acosborn/flow_sensor/projects/flow_sensor/board2/board_all.png

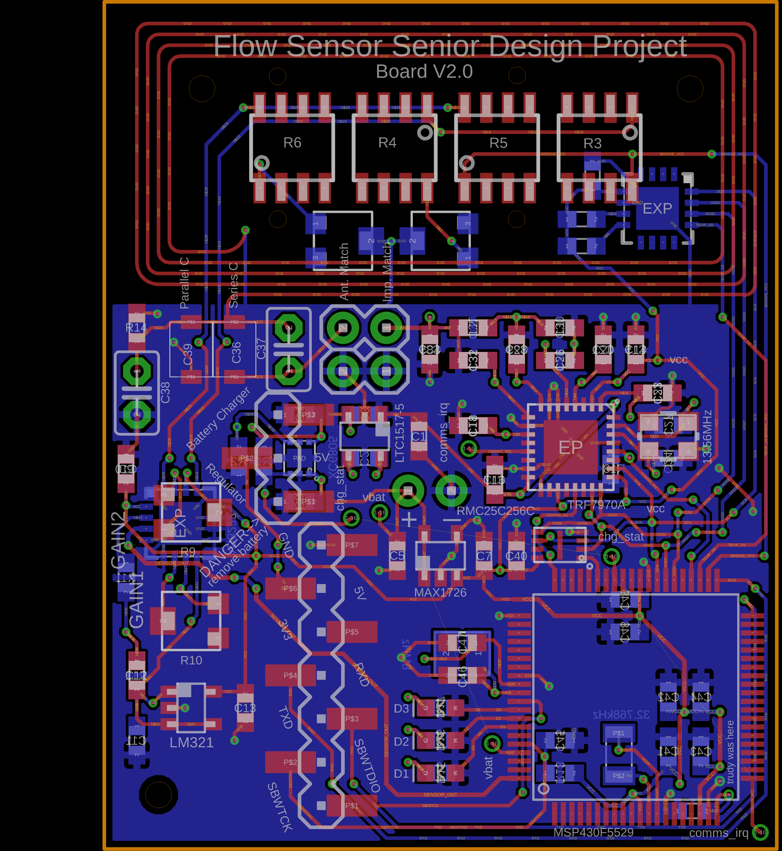
projects/flow_sensor/board2/board_all.png
