acosborn/flow_sensor/projects/flow_sensor/board2/board_bottom.png

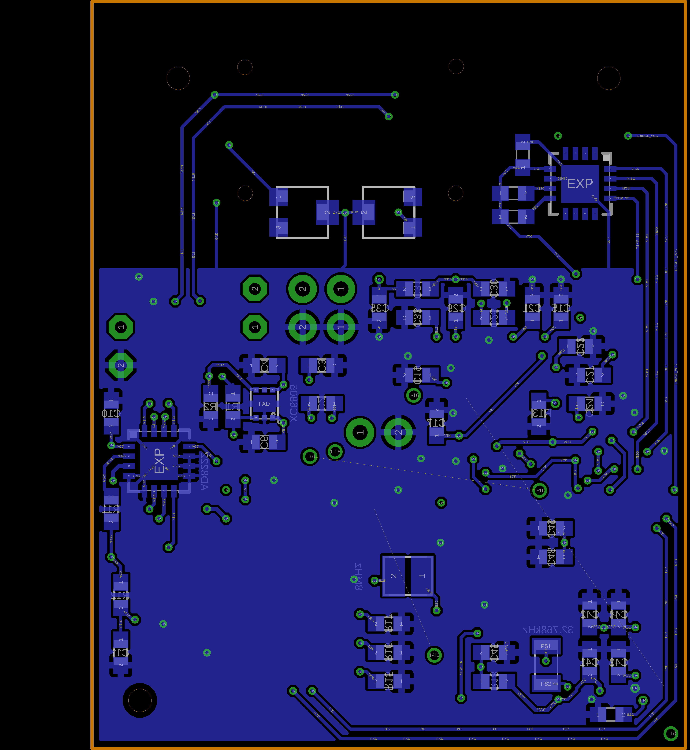
projects/flow_sensor/board2/board_bottom.png
