acosborn/flow_sensor/projects/flow_sensor/board2/board_top.png

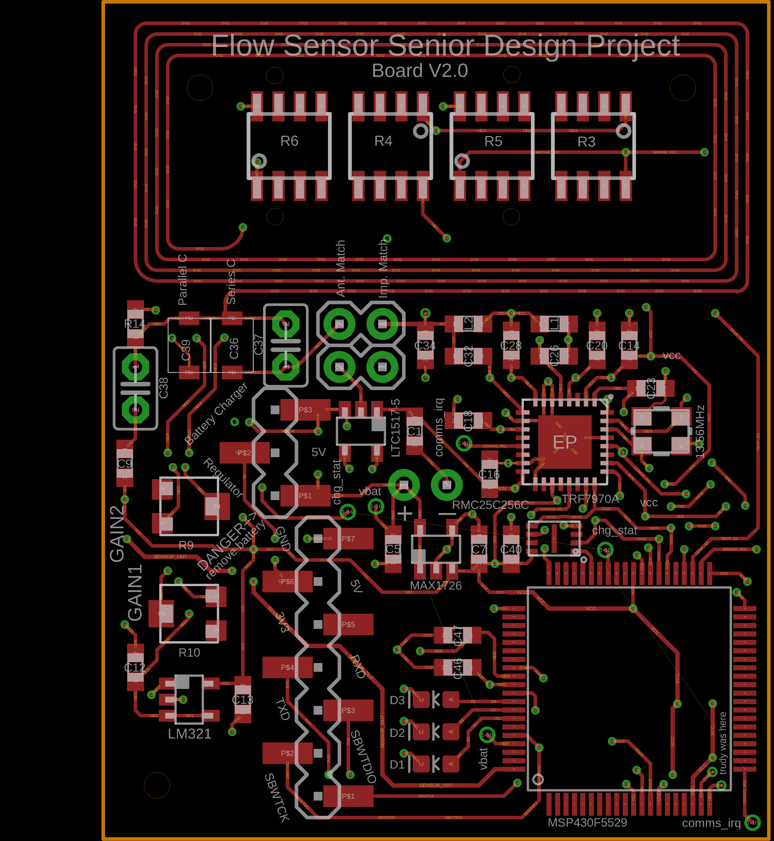
projects/flow_sensor/board2/board_top.png
