acosborn/flow_sensor/projects/flow_sensor/board2/stencil_bottom.png

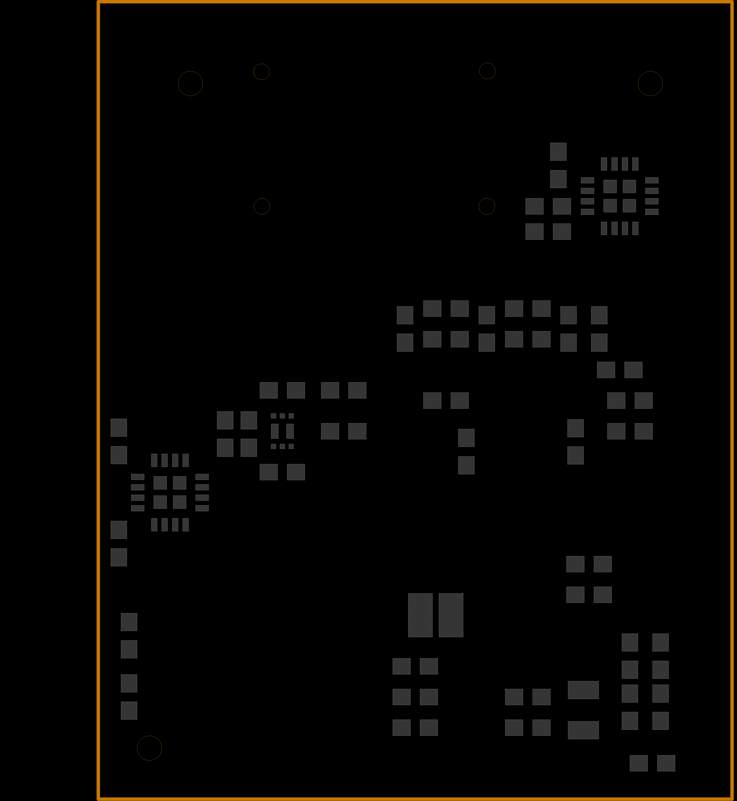
projects/flow_sensor/board2/stencil_bottom.png
