acosborn/flow_sensor/projects/flow_sensor/board2/stencil_top.png

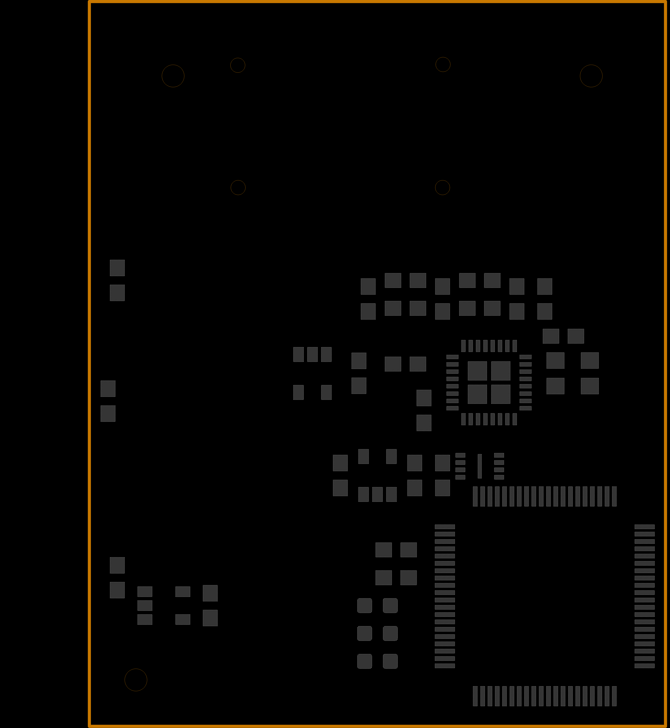
projects/flow_sensor/board2/stencil_top.png
