acosborn/flow_sensor/projects/flow_sensor/board2/board_parts_list.xlsx

Part | Value | Device | Package | Description
R15 | 20Ω | RESISTOR | 0603
R16 | 47Ω | RESISTOR | 0603
R17 | 47Ω | RESISTOR | 0603
R19 | 50Ω | ST-32ETA | ST-32ETA
R20 | 50Ω | ST-32ETA | ST-32ETA
R14 | 680Ω | RESISTOR | 0603
C2 | 0.1uF | CAPACITOR_NONPOLARIZED | 0603
C8 | 0.1uF | CAPACITOR_NONPOLARIZED | 0603
C9 | 0.1uF | CAPACITOR_NONPOLARIZED | 0603
C10 | 0.1uF | CAPACITOR_NONPOLARIZED | 0603
C13 | 0.1uF | CAPACITOR_NONPOLARIZED | 0603
C42 | 0.1uF | CAPACITOR_NONPOLARIZED | 0603
C44 | 0.1uF | CAPACITOR_NONPOLARIZED | 0603
C49 | 0.1uF | CAPACITOR_NONPOLARIZED | 0603
C28 | 1.2nF | CAPACITOR_NONPOLARIZED | 0603
C29 | 1.2nF | CAPACITOR_NONPOLARIZED | 0603
C25 | 1.5nF | CAPACITOR_NONPOLARIZED | 0603
C26 | 1.5nF | CAPACITOR_NONPOLARIZED | 0603
C34 | 100pF | CAPACITOR_NONPOLARIZED | 0603
R7 | 10kΩ | RESISTOR | 0603
R8 | 10kΩ | RESISTOR | 0603
R11 | 10kΩ | RESISTOR | 0603
R12 | 10kΩ | RESISTOR | 0603
R13 | 10kΩ | RESISTOR | 0603
C14 | 10nF | CAPACITOR_NONPOLARIZED | 0603
C16 | 10nF | CAPACITOR_NONPOLARIZED | 0603
C18 | 10nF | CAPACITOR_NONPOLARIZED | 0603
C20 | 10nF | CAPACITOR_NONPOLARIZED | 0603
C22 | 10nF | CAPACITOR_NONPOLARIZED | 0603
C31 | 10pF | CAPACITOR_NONPOLARIZED | 0603
C3 | 10uF | CAPACITOR_NONPOLARIZED | 0603
Y1 | 13.56MHz | CRYSTAL-GROUNDEDSMD-3.2X2.5 | CRYSTAL-SMD-3.2X2.5MM | Crystals w/ Ground Pin (Generic)
L1 | 150nH | INDUCTOR | 0603
R9 | 1kΩ | ST-32ETA | ST-32ETA
R10 | 1kΩ | ST-32ETA | ST-32ETA
C4 | 1uF | CAPACITOR_NONPOLARIZED | 0603
C5 | 1uF | CAPACITOR_NONPOLARIZED | 0603
C6 | 1uF | CAPACITOR_NONPOLARIZED | 0603
C7 | 1uF | CAPACITOR_NONPOLARIZED | 0603
C40 | 1uF | CAPACITOR_NONPOLARIZED | 0603
C41 | 1uF | CAPACITOR_NONPOLARIZED | 0603
C43 | 1uF | CAPACITOR_NONPOLARIZED | 0603
C48 | 1uF | CAPACITOR_NONPOLARIZED | 0603
J2 | 1X03_CONNECTOR | 1X03_CONNECTOR | 1X03_SMD_HEADER
J1 | 1X07_CONNECTOR | 1X07_CONNECTOR | 1X07_SMD_HEADER
C45 | 2.2n | CAPACITOR_NONPOLARIZED | 0603
C15 | 2.2uF | CAPACITOR_NONPOLARIZED | 0603
C17 | 2.2uF | CAPACITOR_NONPOLARIZED | 0603
C19 | 2.2uF | CAPACITOR_NONPOLARIZED | 0603
C21 | 2.2uF | CAPACITOR_NONPOLARIZED | 0603
C23 | 2.2uF | CAPACITOR_NONPOLARIZED | 0603
C32 | 220pF | CAPACITOR_NONPOLARIZED | 0603
R2 | 27kΩ | RESISTOR | 0603
C24 | 27pF | CAPACITOR_NONPOLARIZED | 0603
C27 | 27pF | CAPACITOR_NONPOLARIZED | 0603
C35 | 27pF | CAPACITOR_NONPOLARIZED | 0603
C1 | 3.3uF | CAPACITOR_NONPOLARIZED | 0603
C11 | 3.3uF | CAPACITOR_NONPOLARIZED | 0603
C12 | 3.3uF | CAPACITOR_NONPOLARIZED | 0603
Y2 | 32.768kHz | CRYSTAL-3.2X1.5 | CRYSTAL-3.2X1.5
L2 | 330nH | INDUCTOR | 0603
C50 | 470nF | CAPACITOR_NONPOLARIZED | 0603
R18 | 47kΩ | RESISTOR | 0603
C46 | 47pF | CAPACITOR_NONPOLARIZED | 0603
C47 | 47pF | CAPACITOR_NONPOLARIZED | 0603
C36 | 50pF | TZY2_TRIM_CAP | TZY2_TRIM_CAP
C39 | 50pF | TZY2_TRIM_CAP | TZY2_TRIM_CAP
R1 | 56kΩ | RESISTOR | 0603
C30 | 680pF | CAPACITOR_NONPOLARIZED | 0603
C33 | 680pF | CAPACITOR_NONPOLARIZED | 0603
C37 | 68pF | C2.5/2 | C2.5-2 | CAPACITOR
C38 | 68pF | C2.5/2 | C2.5-2 | CAPACITOR
Y3 | 8MHz | CRYSTAL-3.2X2.5 | CRYSTAL-3.2X2.5
U5 | AD8222 | AD8222 | QFN16-4X4 | Precision
U4 | ADT7320 | ADT7320 | QFN16-4X4
U9 | F552X---PN80 | F552X---PN80 | PN80 | ***MSP430F552X***PN80
U6 | LM321 | LM321 | SOT-23-5 | Low-power
U1 | LTC1517-5 | LTC1517-5 | SOT-23-5 | Micropower
U3 | MAX1726 | MAX1726 | SOT-23-5
U8 | RM25C256C | RM25C256C | DFN8-2X3
R3 | STJ-240 | STJ-240 | SOIC-8-NOCREAM
R4 | STJ-240 | STJ-240 | SOIC-8-NOCREAM
R5 | STJ-240 | STJ-240 | SOIC-8-NOCREAM
R6 | STJ-240 | STJ-240 | SOIC-8-NOCREAM
U7 | TRF7970A | TRF7970A | QFN-32 | Multi-Protocol Fully Integrated 13.56-MHz NFC / RFID Transceiver IC
U2 | XC6805 | XC6805 | DFN6-1.8X2.0 | Single-Cell Li-ion/Li-polymer Linear Charger IC - Vin:4.5-6V - Iq:100uA - Icc: 5-40mA - Vcv: 4.2V
D1 |  | LED0603 | LED-0603 | LED (Generic)
D2 |  | LED0603 | LED-0603 | LED (Generic)
D3 |  | LED0603 | LED-0603 | LED (Generic)
J3 |  | CONN_021X02_NO_SILK | 1X02_NO_SILK | Multi connection point. Often used as Generic Header-pin footprint for 0.1 inch spaced/style header connections
J4 |  | CONN_02 | 1X02 | Multi connection point. Often used as Generic Header-pin footprint for 0.1 inch spaced/style header connections
J5 |  | CONN_02 | 1X02 | Multi connection point. Often used as Generic Header-pin footprint for 0.1 inch spaced/style header connections
