acosborn/flow_sensor/projects/flow_sensor/board2/board_parts_order.xlsx

Qty | Link | Value | Device | Package | Parts | Description
2 |  |  | CONN_02 | 1X02 | J4 J5 | Multi connection point. Often used as Generic Header-pin footprint for 0.1 inch spaced/style header connections
1 |  |  | CONN_021X02_NO_SILK | 1X02_NO_SILK | J3 | Multi connection point. Often used as Generic Header-pin footprint for 0.1 inch spaced/style header connections
1 | https://www.digikey.com/product-detail/en/rohm-semiconductor/SMLE13BC8TT86/846-1177-1-ND/5053794 | blue | LED-BLUE-0603 | LED-0603 | D1 | LED (Generic)
1 | https://www.digikey.com/product-detail/en/lite-on-inc/LTST-C191KGKT/160-1446-1-ND/386834 | green | LED-GREEN-0603 | LED-0603 | D2 | LED (Generic)
1 | https://www.digikey.com/product-detail/en/lite-on-inc/LTST-C191KRKT/160-1447-1-ND/386836 | red | LED-RED-0603 | LED-0603 | D3 | LED (Generic)
8 | https://www.digikey.com/product-detail/en/avx-corporation/06033C104JAZ2A/478-10279-1-ND/6797272 | 0.1uF | CAPACITOR_NONPOLARIZED | 0603 | C2 C8 C9 C10 C13 C42 C44 C49
2 | https://www.digikey.com/product-detail/en/samsung-electro-mechanics/CL10C122JB8NNNC/1276-2184-1-ND/3890270 | 1.2nF | CAPACITOR_NONPOLARIZED | 0603 | C28 C29
2 | https://www.digikey.com/product-detail/en/murata-electronics-north-america/GRM1885C1H152FA01D/490-11446-1-ND/5333286 | 1.5nF | CAPACITOR_NONPOLARIZED | 0603 | C25 C26
1 | https://www.digikey.com/product-detail/en/avx-corporation/06035A101FAT2A/478-6202-1-ND/2391401 | 100pF | CAPACITOR_NONPOLARIZED | 0603 | C34
5 | https://www.digikey.com/product-detail/en/rohm-semiconductor/ESR03EZPJ103/RHM10KDCT-ND/1762925 | 10k | RESISTOR | 0603 | R7 R8 R11 R12 R13
5 | https://www.digikey.com/product-detail/en/murata-electronics-north-america/GRM188R71H103JA01D/490-9734-1-ND/4934907 | 10nF | CAPACITOR_NONPOLARIZED | 0603 | C14 C16 C18 C20 C22
1 | https://www.digikey.com/product-detail/en/murata-electronics-north-america/GCM1885C1H100FA16D/490-12530-1-ND/5798053 | 10pF | CAPACITOR_NONPOLARIZED | 0603 | C31
1 | https://www.digikey.com/product-detail/en/taiyo-yuden/LMK107BBJ106MALT/587-3258-1-ND/3662218 | 10uF | CAPACITOR_NONPOLARIZED | 0603 | C3
1 | https://www.digikey.com/product-detail/en/abracon-llc/ABM8G-13.560MHZ-18-D2Y-T/535-10264-1-ND/2218077 | 13.56MHz | CRYSTAL-GROUNDEDSMD-3.2X2.5 | CRYSTAL-SMD-3.2X2.5MM | Y1 | Crystals w/ Ground Pin (Generic)
1 | https://www.digikey.com/product-detail/en/murata-electronics-north-america/LQW18ASR15G0ZD/490-15868-1-ND/6800533 | 150nH | INDUCTOR | 0603 | L1
1 |  | 1X03_CONNECTOR | 1X03_CONNECTOR | 1X03_SMD_HEADER | J2
1 |  | 1X07_CONNECTOR | 1X07_CONNECTOR | 1X07_SMD_HEADER | J1
2 | https://www.digikey.com/product-detail/en/nidec-copal-electronics/ST32ETA102/ST32ETA102CT-ND/738467 | 1k | ST-32ETA | ST-32ETA | R9 R10
8 | https://www.digikey.com/product-detail/en/samsung-electro-mechanics/CL10B105KO8NNNC/1276-1019-1-ND/3889105 | 1uF | CAPACITOR_NONPOLARIZED | 0603 | C4 C5 C6 C7 C40 C41 C43 C48
1 | https://www.digikey.com/product-detail/en/murata-electronics-north-america/GCM1885C1H222FA16D/490-16421-1-ND/7363403 | 2.2n | CAPACITOR_NONPOLARIZED | 0603 | C45
5 | https://www.digikey.com/product-detail/en/taiyo-yuden/EMK107BJ225KA-T/587-1430-1-ND/1004061 | 2.2uF | CAPACITOR_NONPOLARIZED | 0603 | C15 C17 C19 C21 C23
1 | https://www.digikey.com/product-detail/en/vishay-dale/CRCW060320R0FKEAHP/541-20.0SCT-ND/2825991 | 20 | RESISTOR | 0603 | R15
1 | https://www.digikey.com/product-detail/en/kemet/C0603C221F5GACTU/399-7876-1-ND/3471599 | 220pF | CAPACITOR_NONPOLARIZED | 0603 | C32
1 | https://www.digikey.com/product-detail/en/vishay-beyschlag/MCT06030C2702FP500/MCT0603-27.0K-CFCT-ND/2607898 | 27k | RESISTOR | 0603 | R2
3 | https://www.digikey.com/product-detail/en/avx-corporation/06035A270FAT2A/478-10305-1-ND/6797555 | 27pF | CAPACITOR_NONPOLARIZED | 0603 | C24 C27 C35
3 | https://www.digikey.com/product-detail/en/tdk-corporation/C1608X5R1C335K080AC/445-7476-1-ND/2733548 | 3.3uF | CAPACITOR_NONPOLARIZED | 0603 | C1 C11 C12
1 | https://www.digikey.com/product-detail/en/ecs-inc/ECS-.327-12.5-34B-TR/XC1617CT-ND/1693786 | 32.768kHz | CRYSTAL-3.2X1.5 | CRYSTAL-3.2X1.5 | Y2
1 | https://www.digikey.com/product-detail/en/tdk-corporation/MLF1608DR33JTD25/445-16961-1-ND/4869761 | 330nH | INDUCTOR | 0603 | L2
2 | https://www.digikey.com/product-detail/en/susumu/RL0816S-470-F/408-1388-1-ND/2734766 | 47 | RESISTOR | 0603 | R16 R17
1 | https://www.digikey.com/product-detail/en/murata-electronics-north-america/GCM188R71C474KA55D/490-4775-1-ND/1641694 | 470nF | CAPACITOR_NONPOLARIZED | 0603 | C50
1 | https://www.digikey.com/product-detail/en/panasonic-electronic-components/ERJ-PA3F4702V/P47KBYCT-ND/5036196 | 47k | RESISTOR | 0603 | R18
2 | https://www.digikey.com/product-detail/en/avx-corporation/06031A470FAT2A/478-3691-1-ND/1116389 | 47pF | CAPACITOR_NONPOLARIZED | 0603 | C46 C47
2 | https://www.digikey.com/product-detail/en/nidec-copal-electronics/ST32ETA500/ST32ETA500CT-ND/738475 | 50 | ST-32ETA | ST-32ETA | R19 R20
2 | https://www.digikey.com/product-detail/en/murata-electronics-north-america/TZY2K450AC01R00/490-12513-1-ND/5719518 | 50pF | TZY2_TRIM_CAP | TZY2_TRIM_CAP | C36 C39
1 | https://www.digikey.com/product-detail/en/vishay-beyschlag/MCT06030C5602FP500/749-1667-1-ND/7347975 | 56k | RESISTOR | 0603 | R1
1 | https://www.digikey.com/product-detail/en/vishay-beyschlag/MCT06030C6800FP500/MCT0603-680-CFCT-ND/2607916 | 680 | RESISTOR | 0603 | R14
2 | https://www.digikey.com/product-detail/en/murata-electronics-north-america/GRM1885C1H681GA01D/490-11476-1-ND/5333316 | 680pF | CAPACITOR_NONPOLARIZED | 0603 | C30 C33
2 | https://www.digikey.com/product-detail/en/kemet/C317C680G2G5TA/399-14061-ND/6562472 | 68pF | C2.5/2 | C2.5-2 | C37 C38 | CAPACITOR
1 | https://www.digikey.com/product-detail/en/ndk-america-inc/NX3225GD-8MHZ-STD-CRA-3/644-1178-1-ND/3125567 | 8MHz | CRYSTAL-3.2X2.5 | CRYSTAL-3.2X2.5 | Y3
1 | https://www.digikey.com/product-detail/en/analog-devices-inc/AD8222ACPZ-R7/AD8222ACPZ-R7CT-ND/1206747 | AD8222 | AD8222 | QFN16-4X4 | U5 | Precision
1 | https://www.digikey.com/product-detail/en/analog-devices-inc/ADT7320UCPZ-RL7/ADT7320UCPZ-RL7CT-ND/4248446 | ADT7320 | ADT7320 | QFN16-4X4 | U4
1 | https://www.digikey.com/product-detail/en/texas-instruments/MSP430F5529IPNR/296-27306-1-ND/2273807 | F552X---PN80 | F552X---PN80 | PN80 | U9 | ***MSP430F552X***PN80
1 | https://www.digikey.com/product-detail/en/texas-instruments/LM321MFX-NOPB/LM321MFX-NOPBCT-ND/3440175 | LM321 | LM321 | SOT-23-5 | U6 | Low-power
1 | https://www.digikey.com/product-detail/en/linear-technology-analog-devices/LTC1517ES5-5-TRMPBF/LTC1517ES5-5-TRMPBFCT-ND/890804 | LTC1517-5 | LTC1517-5 | SOT-23-5 | U1 | Micropower
1 | https://www.digikey.com/product-detail/en/maxim-integrated/MAX1726EUK33-T/MAX1726EUK33-TCT-ND/2699399 | MAX1726 | MAX1726 | SOT-23-5 | U3
1 | https://www.digikey.com/product-detail/en/adesto-technologies/RM25C256C-LMAI-T/1265-1211-1-ND/5972812 | RM25C256C | RM25C256C | DFN8-2X3 | U8
4 |  | STJ-240 | STJ-240 | SOIC-8-NOCREAM | R3 R4 R5 R6
1 | https://www.digikey.com/product-detail/en/texas-instruments/TRF7970ARHBR/296-29355-1-ND/2728041 | TRF7970A | TRF7970A | QFN-32 | U7 | Multi-Protocol Fully Integrated 13.56-MHz NFC / RFID Transceiver IC
1 | https://www.digikey.com/product-detail/en/torex-semiconductor-ltd/XC6805A2D14R-G/893-1314-1-ND/6137363 | XC6805 | XC6805 | DFN6-1.8X2.0 | U2 | Single-Cell Li-ion/Li-polymer Linear Charger IC - Vin:4.5-6V - Iq:100uA - Icc: 5-40mA - Vcv: 4.2V
