acosborn/flow_sensor/projects/flow_sensor/flow_sensor.brd

## EAGLE design projects/flow_sensor/flow_sensor.brd (2018-05-01)

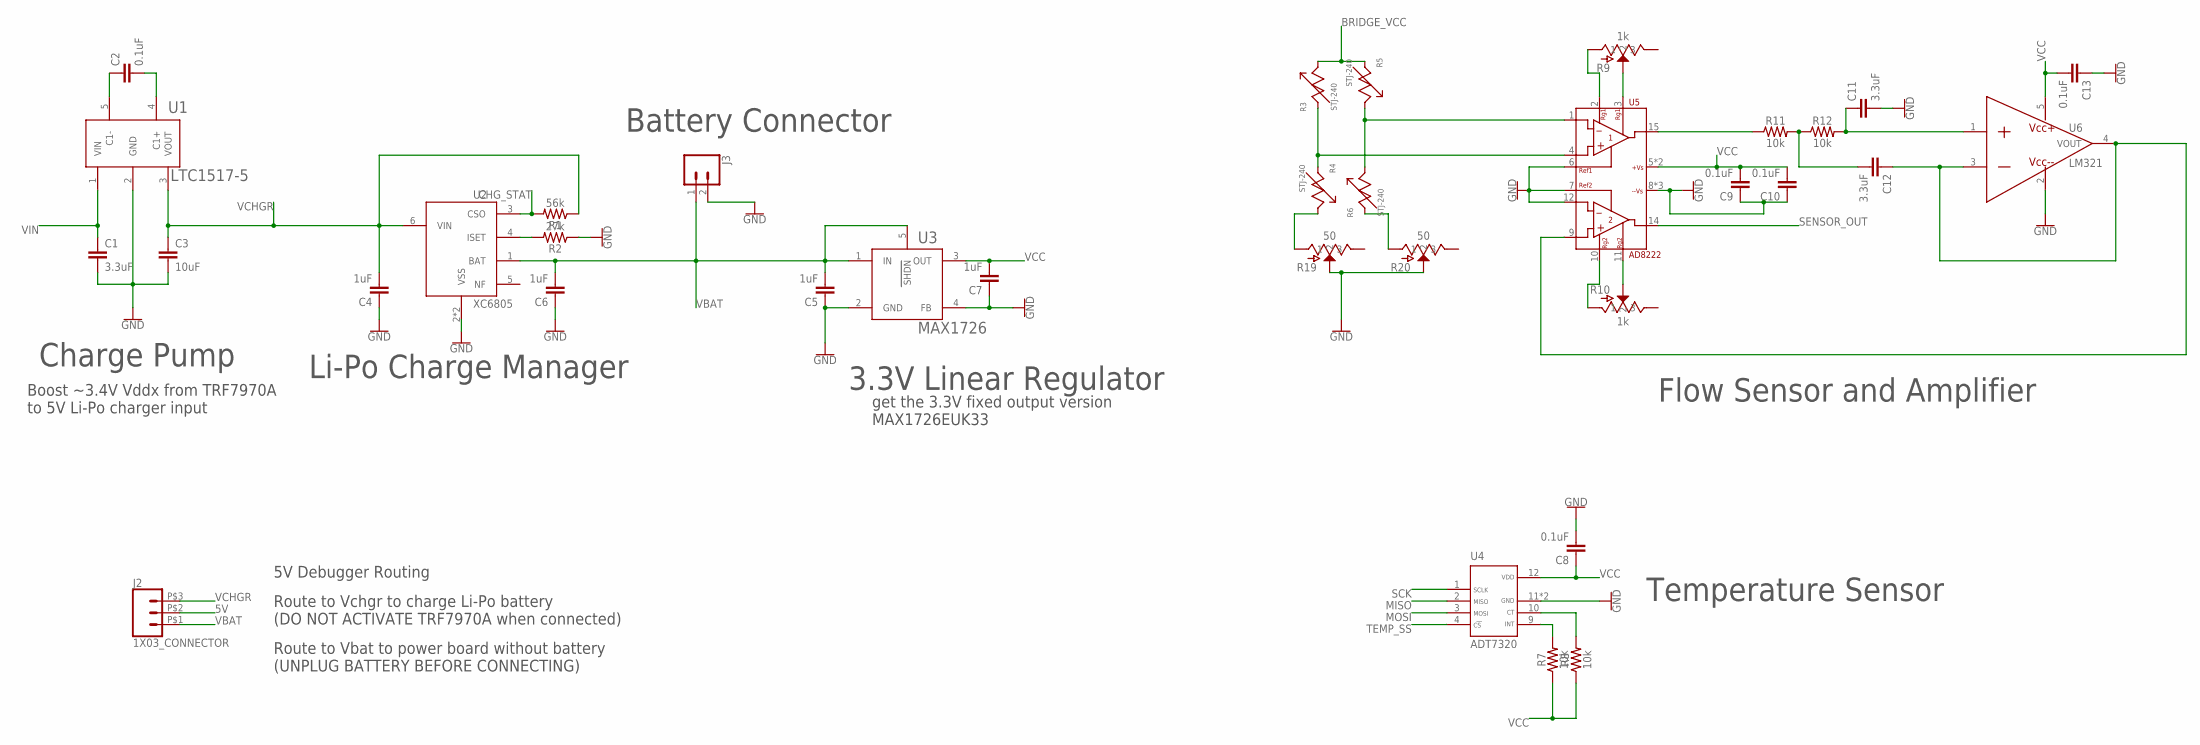
[picture p6: schematic flow_sensor.sch, sheet 1]

Parts:
C1, C11, C12: 3.3uF; 0603
C2, C8, C9, C10, C13: 0.1uF; 0603
C3: 10uF; 0603
C4, C5, C6, C7: 1uF; 0603
J2: 1X03_CONNECTOR; 1X03_SMD_HEADER
J3: CONN_021X02_NO_SILK; 1X02_NO_SILK
R1: 56k; 0603
R2: 27k; 0603
R3, R4, R5, R6: STJ-240; SOIC-8-NOCREAM
R7, R8, R11, R12: 10k; 0603
R9, R10: 1k; ST-32ETA
R19, R20: 50; ST-32ETA
U1: LTC1517-5; SOT-23-5
U2: XC6805; DFN6-1.8X2.0
U3: MAX1726; SOT-23-5
U4: ADT7320; QFN16-4X4
U5: AD8222; QFN16-4X4
U6: LM321; SOT-23-5

Connections:
5V: J2.P$2 (2); also elsewhere on the board
BRIDGE_VCC: R3.8, R5.1; also elsewhere on the board
CHG_STAT: R1.2, U2.3 (CSO); also elsewhere on the board
GND: C1.2, C3.2, C4.1, C5.1, C6.1, C7.1, C8.2, C9.1, C10.1, C11.2, C13.1, J3.2, R2.1, R19.2, R20.2, U1.2 (GND), U2.2 (VSS), U2.PAD (VSS), U3.2 (GND), U3.4 (FB), U4.11 (GND), U4.EXP (GND), U5.6 (REF1), U5.7 (REF2), U5.8 (-VS), U5.12 (-IN2), U5.13 (-VS), U5.EXP (-VS), U6.2 (VCC-); also elsewhere on the board
MISO: U4.2 (MISO); also elsewhere on the board
MOSI: U4.3 (MOSI); also elsewhere on the board
unnamed: C2.1, U1.5 (C1-)
unnamed: C2.2, U1.4 (C1+)
unnamed: R4.8, R19.1
unnamed: R7.2, U4.9 (INT)
unnamed: R6.1, R20.1
unnamed: R10.1, U5.10 (RG2)
unnamed: R3.1, R4.1, U5.4 (+IN1)
unnamed: C11.1, R12.2, U6.1 (IN+)
unnamed: C12.1, U5.9 (+IN2), U6.3 (IN-), U6.4 (VOUT)
unnamed: R9.1, U5.2 (RG1)
unnamed: R10.2, U5.11 (RG2')
unnamed: R8.2, U4.10 (CT)
unnamed: R9.2, U5.3 (RG1')
unnamed: R5.8, R6.8, U5.1 (-IN1)
unnamed: C12.2, R11.2, R12.1
unnamed: R2.2, U2.4 (ISET)
unnamed: R11.1, U5.15 (OUT1)
SCK: U4.1 (SCLK); also elsewhere on the board
SENSOR_OUT: U5.14 (OUT2); also elsewhere on the board
TEMP_SS: U4.4 (CS); also elsewhere on the board
VBAT: C5.2, C6.2, J2.P$1 (1), J3.1, U2.1 (BAT), U3.1 (IN), U3.5 (SHDN); also elsewhere on the board
VCC: C7.2, C8.1, C9.2, C10.2, C13.2, R7.1, R8.1, U3.3 (OUT), U4.12 (VDD), U5.5 (+VS), U5.16 (+VS), U6.5 (VCC+); also elsewhere on the board
VCHGR: C3.1, C4.2, J2.P$3 (3), R1.1, U1.3 (VOUT), U2.6 (VIN)
VIN: C1.1, U1.1 (VIN); also elsewhere on the board

Notes on the sheet:
get the 3.3V fixed output version MAX1726EUK33
Battery Connector
3.3V Linear Regulator
Li-Po Charge Manager
5V Debugger Routing
Route to Vchgr to charge Li-Po battery (DO NOT ACTIVATE TRF7970A when connected)
Route to Vbat to power board without battery (UNPLUG BATTERY BEFORE CONNECTING)
Temperature Sensor
Flow Sensor and Amplifier
Charge Pump
Boost ~3.4V Vddx from TRF7970A to 5V Li-Po charger input

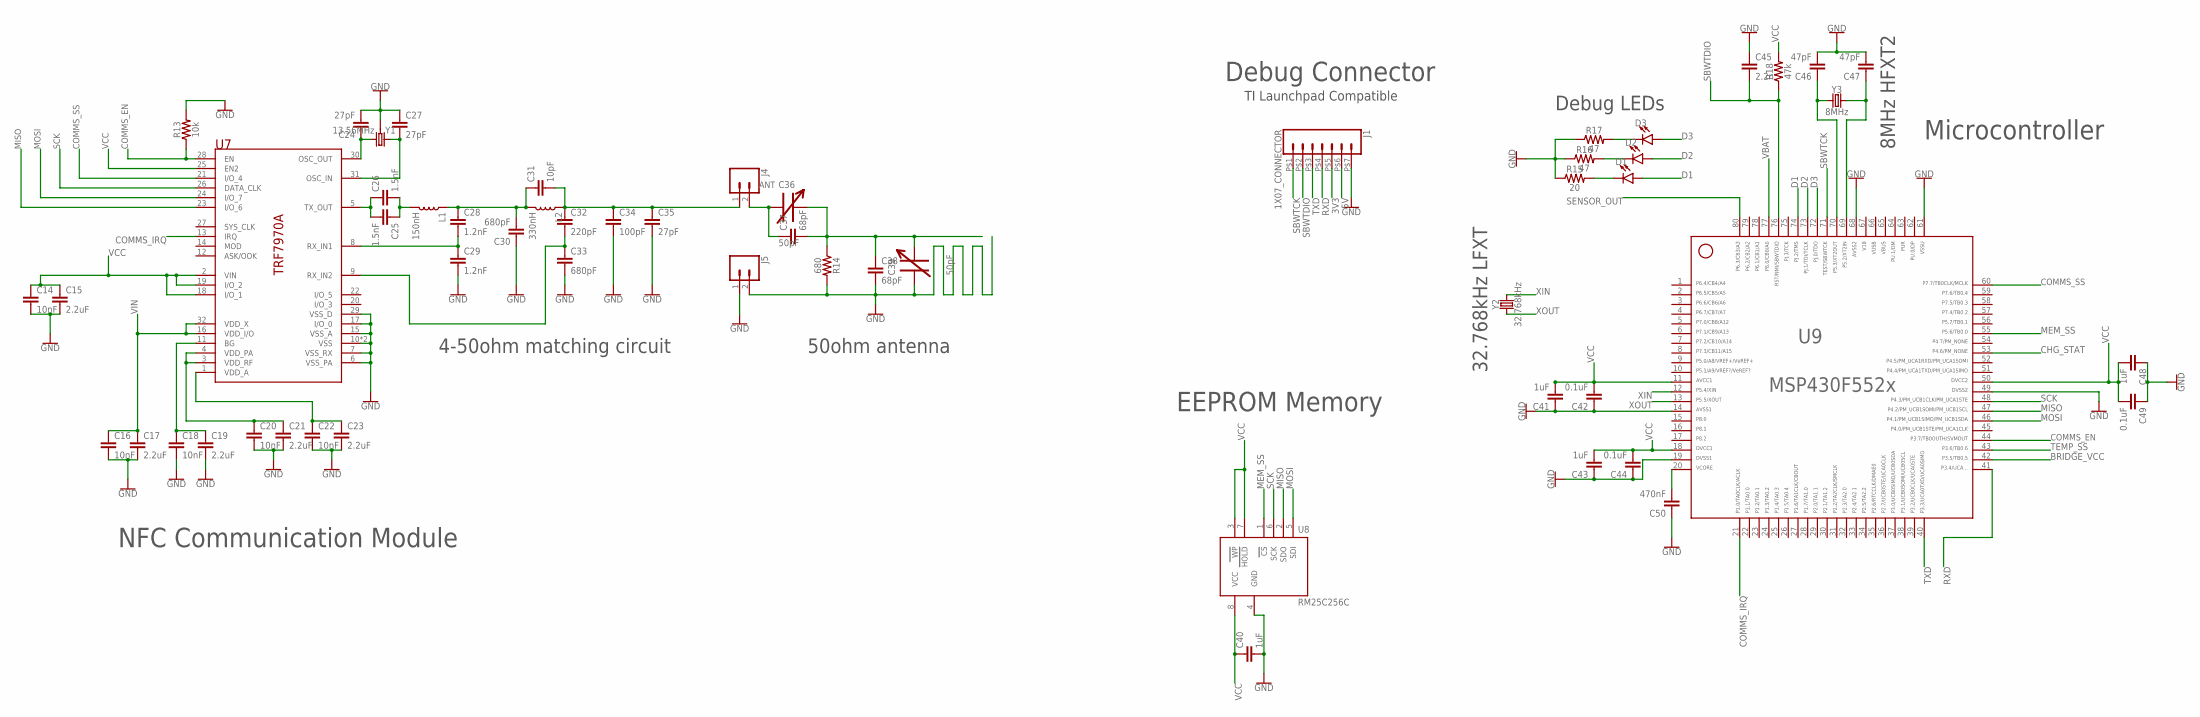
[picture p7: schematic flow_sensor.sch, sheet 2]

Parts:
C14, C16, C18, C20, C22: 10nF; 0603
C15, C17, C19, C21, C23: 2.2uF; 0603
C24, C27, C35: 27pF; 0603
C25, C26: 1.5nF; 0603
C28, C29: 1.2nF; 0603
C30, C33: 680pF; 0603
C31: 10pF; 0603
C32: 220pF; 0603
C34: 100pF; 0603
C36, C39: 50pF; TZY2_TRIM_CAP
C37, C38: 68pF; C2.5-2
C40, C41, C43, C48: 1uF; 0603
C42, C44, C49: 0.1uF; 0603
C45: 2.2n; 0603
C46, C47: 47pF; 0603
C50: 470nF; 0603
D1, D2, D3: LED0603; LED-0603
J1: 1X07_CONNECTOR; 1X07_SMD_HEADER
J4, J5: CONN_02; 1X02
L1: 150nH; 0603
L2: 330nH; 0603
R13: 10k; 0603
R14: 680; 0603
R15: 20; 0603
R16, R17: 47; 0603
R18: 47k; 0603
U7: TRF7970A; QFN-32
U8: RM25C256C; DFN8-2X3
U9: F552X---PN80; PN80
Y1: 13.56MHz; CRYSTAL-SMD-3.2X2.5MM
Y2: 32.768kHz; CRYSTAL-3.2X1.5
Y3: 8MHz; CRYSTAL-3.2X2.5

Connections:
3V3: J1.P$5 (5)
5V: J1.P$6 (6); also elsewhere on the board
65: U9.65
66: U9.66
67: U9.67
ANT: C31.2, C32.1, C34.1, C35.1, J4.1, L2.1
BRIDGE_VCC: U9.42; also elsewhere on the board
CHG_STAT: U9.53; also elsewhere on the board
COMMS_EN: R13.1, U7.28 (EN), U9.44
COMMS_IRQ: U7.13 (IRQ), U9.21
COMMS_SS: U7.21 (I/O_4), U9.60
D1: D1.A, U9.74
D2: D2.A, U9.73
D3: D3.A, U9.72
GND: C14.2, C15.2, C16.2, C17.2, C18.2, C19.2, C20.2, C21.2, C22.2, C23.2, C24.2, C27.1, C29.2, C30.1, C33.2, C34.2, C35.2, C38.2, C39.P$1, C40.2, C41.1, C42.1, C43.1, C44.1, C45.1, C46.2, C47.2, C48.1, C49.1, C50.1, J1.P$7 (7), J5.1, J5.2, R13.2, R14.2, R15.1, R16.1, R17.1, U7.6 (VSS_PA), U7.7 (VSS_RX), U7.10 (VSS), U7.15 (VSS_A), U7.17 (I/O_0), U7.29 (VSS_D), U7.EP (VSS), U8.4 (GND), U9.14, U9.19, U9.49, U9.61, U9.68, Y1.2 (3), Y1.4 (3); also elsewhere on the board
MEM_SS: U8.1 (CS), U9.55
MISO: U7.23 (I/O_6), U8.2 (SDO), U9.47; also elsewhere on the board
MOSI: U7.24 (I/O_7), U8.5 (SDI), U9.46; also elsewhere on the board
unnamed: D2.C, R16.2
unnamed: C24.1, U7.30 (OSC_OUT), Y1.3 (2)
unnamed: C18.1, C19.1, U7.11 (BG)
unnamed: C20.1, C21.1, U7.3 (VDD_RF), U7.4 (VDD_PA)
unnamed: C27.2, U7.31 (OSC_IN), Y1.1
unnamed: C22.1, C23.1, U7.1 (VDD_A)
unnamed: C25.2, C26.1, U7.5 (TX_OUT)
unnamed: C28.1, C30.2, C31.1, L1.1, L2.2
unnamed: C28.2, C29.1, U7.8 (RX_IN1)
unnamed: C25.1, C26.2, L1.2
unnamed: C32.2, C33.1, U7.9 (RX_IN2)
unnamed: C36.P$2, C37.2, C38.1, C39.P$2, R14.1
unnamed: C36.P$1, C37.1, J4.2
unnamed: C47.1, U9.69, Y3.2
unnamed: C46.1, U9.70, Y3.1
unnamed: C50.2, U9.20
unnamed: D3.C, R17.2
unnamed: D1.C, R15.2
RXD: J1.P$4 (4), U9.41
SBWTCK: J1.P$1 (1), U9.71
SBWTDIO: C45.2, J1.P$2 (2), R18.1, U9.76
SCK: U7.26 (DATA_CLK), U8.6 (SCK), U9.48; also elsewhere on the board
SENSOR_OUT: U9.80; also elsewhere on the board
TEMP_SS: U9.43; also elsewhere on the board
TXD: J1.P$3 (3), U9.40
VBAT: U9.77; also elsewhere on the board
VCC: C14.1, C15.1, C40.1, C41.2, C42.2, C43.2, C44.2, C48.2, C49.2, R18.2, U7.2 (VIN), U7.18 (I/O_1), U7.19 (I/O_2), U7.25 (EN2), U8.3 (WP), U8.7 (HOLD), U8.8 (VCC), U9.11, U9.18, U9.50; also elsewhere on the board
VIN: C16.1, C17.1, U7.16 (VDD_I/O), U7.32 (VDD_X); also elsewhere on the board
XIN: U9.12, Y2.P$2 (2)
XOUT: U9.13, Y2.P$1 (1)

Notes on the sheet:
Debug Connector
TI Launchpad Compatible
EEPROM Memory
Debug LEDs
8MHz HFXT2
32.768kHz LFXT
Microcontroller
NFC Communication Module
4-50ohm matching circuit
50ohm antenna

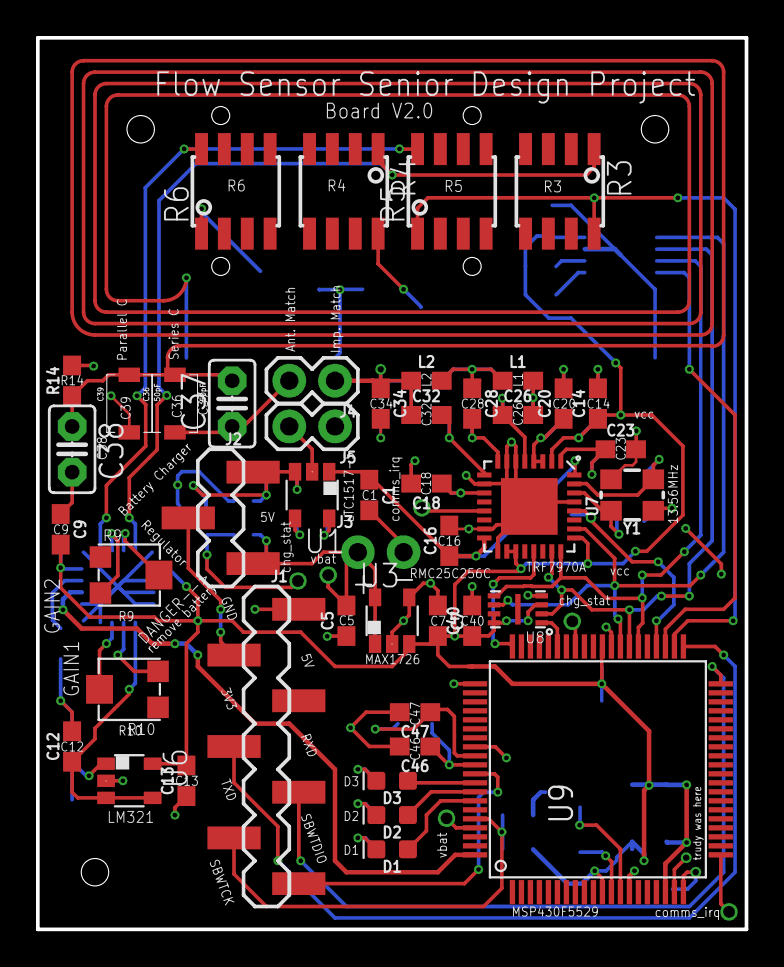
[picture p8: board flow_sensor.brd from above]

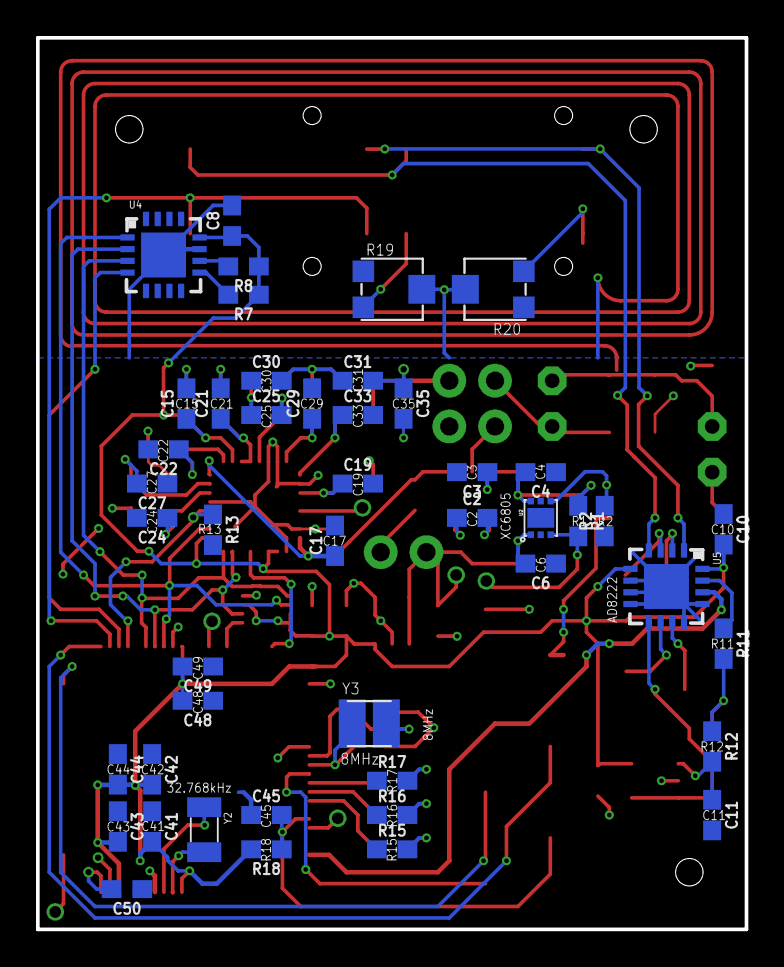
[picture p9: board flow_sensor.brd from below]

Board: 2 copper layers, 39.4 x 49.5 mm, 92 parts (46 on the bottom side), 62 nets.
