acosborn/flow_sensor/(commit log)

2017-12-21 Repository Created
    [flow_sensor.sch]
2017-12-21 Adjusted AD8222 schematic part
    [flow_sensor.sch]
2018-01-01 AD8222 modified in library and connected in schematic
    [flow_sensor.sch]
2018-01-01 Added LM8209 to library, finished sensor schematic
    [flow_sensor.sch]
2018-01-04 Completed MSP430FR5994 part in library
    [flow_sensor.sch]
2018-01-05 fixed BAS4002A pinout, added decoupling capacitors to uC
    [flow_sensor.sch]
2018-01-08 Added Spi-Bi-Wire to uC, added SPI connections between uC/NFC
    [flow_sensor.sch]
2018-01-10 Fixed BAS4002A part again
    [flow_sensor.sch]
2018-01-12 Added QFN20-3.5mmx4.5mm package to library
2018-01-24 Modified sensor: Added mux, reduced op-amps
    [flow_sensor.sch]
2018-01-24 Resubmitting work for 1/24/18
    [flow_sensor.sch]
2018-01-24 Changed sensor schematic to have 1 wheatstone bridge with 4 sensors
    [flow_sensor.sch]
2018-01-27 Modified power supply to run off of NFC chip supply
    [flow_sensor.sch]
2018-03-08 Board created, general save dump
    [flow_sensor.sch]
2018-03-09 Second data dump. Board Layout Complete
    [flow_sensor.sch]
2018-03-09 forgot to add board back to tracking
    [flow_sensor.brd]
2018-03-09 Touched up board V1.0, added labels
    [flow_sensor.brd, flow_sensor.sch]
2018-03-09 Finalized Board Size, touched up labels
    [flow_sensor.brd]
2018-03-13 gerbers sent to fab v1.0
    [.drills.xln]
2018-03-13 starting v2.0
    [flow_sensor.brd, flow_sensor.sch]
2018-03-19 added stuff for board v2
    [flow_sensor.brd, flow_sensor.sch]
2018-04-03 Added MSP430F5229 to replace MSP430FR5994
    [flow_sensor.brd, flow_sensor.sch]
2018-04-04 Added XC6805 battery charger to replace mcp73832
    [flow_sensor.sch]
2018-04-04 Added MAX1726 linear regulator and replaced circuit-side boost converter
    [flow_sensor.brd, flow_sensor.sch]
2018-04-04 Added LTC1517-5 charge pump to replace battery-site boost converter
    [flow_sensor.brd, flow_sensor.sch]
2018-04-04 Added RM25C256C EEPROM for external data storage
    [flow_sensor.brd, flow_sensor.sch]
2018-04-06 Beginning v2.0 routing
    [flow_sensor.brd, flow_sensor.sch]
2018-04-09 Tentative board v2.0 complete
    [flow_sensor.brd, flow_sensor.sch]
2018-04-11 Replaced 32k and 4M oscillator packages, added magnetic sensors, minor rewiring; board 2 almost ready for order
    [flow_sensor.brd, flow_sensor.sch]
2018-04-13 Rewired SBW interface pins, LEDs, and Vbat bridge wire
    [flow_sensor.brd, flow_sensor.sch]
2018-04-13 Board 2 complete
    [board_parts_list.xlsx, board_parts_order.xlsx, flow_sensor.brd, flow_sensor.sch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]
2018-04-18 Not important changes to board v2: WP and HOLD on EEPROM connected, shifted top 2 channel tiedown holes 1 mil right
    [flow_sensor.brd, flow_sensor.sch]
2018-04-25 Added documentation to schematic
    [flow_sensor.sch]
2018-05-01 Small adjustment to routes for memory module
    [flow_sensor.brd]
